IgorZeitz/PidgeonGuard/README_Images/schema.pdf

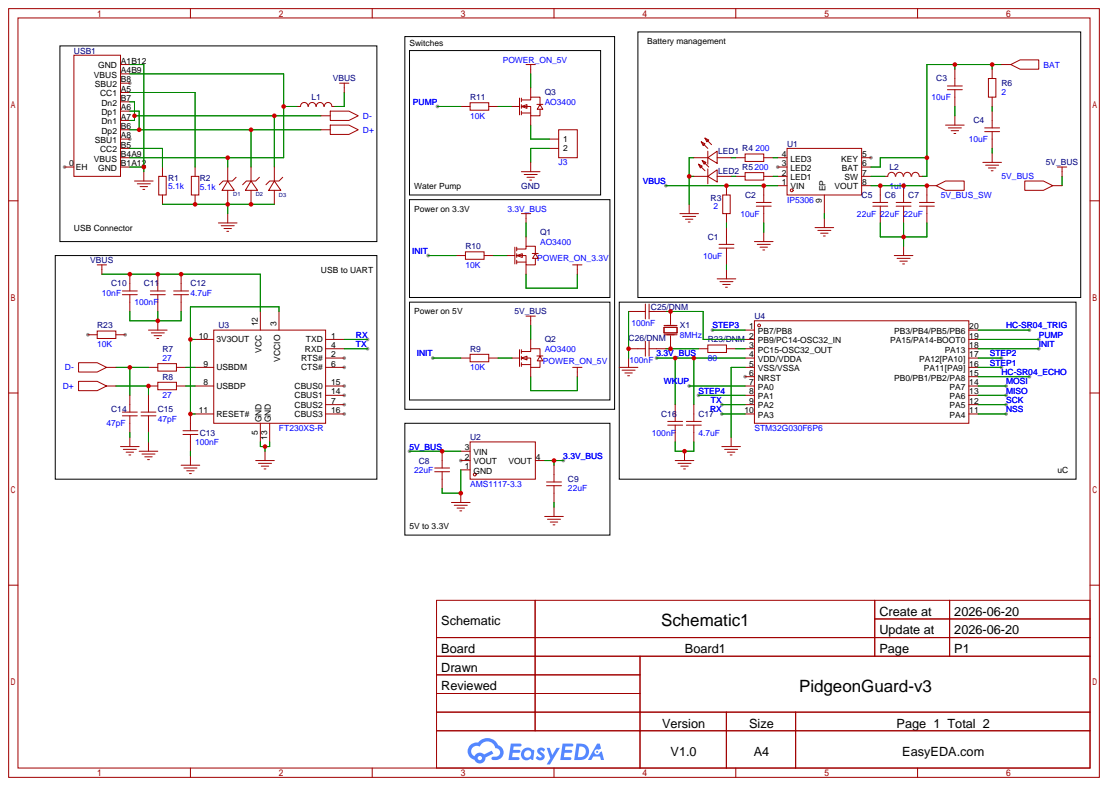
[picture p18: page 1]

Schematic | Schematic1 | Create at | 2026-06-20

Update at | 2026-06-20

Board | Board1 | Page | P1
Drawn | | PidgeonGuard-v3
Reviewed

Version | Size | Page 1 Total 2
V1.0 | A4 | EasyEDA.com

### MIC

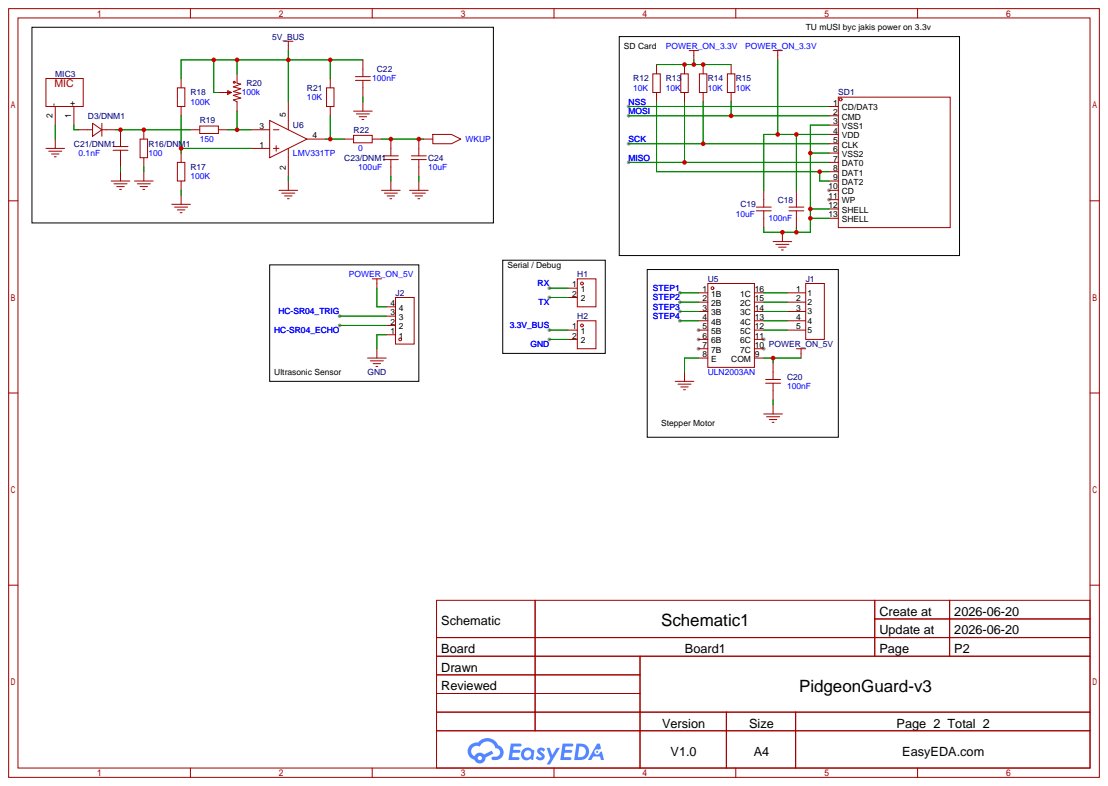
[picture p19: page 2]

TU mUSI byc jakis power on 3.3v

Schematic | Schematic1 | Create at | 2026-06-20

Update at | 2026-06-20

Board | Board1 | Page | P2
Drawn | | PidgeonGuard-v3
Reviewed

Version | Size | Page 2 Total 2
V1.0 | A4 | EasyEDA.com
