IgorZeitz/PidgeonGuard/README_Images/PCB_PCB1_2026-06-20_bot.pdf

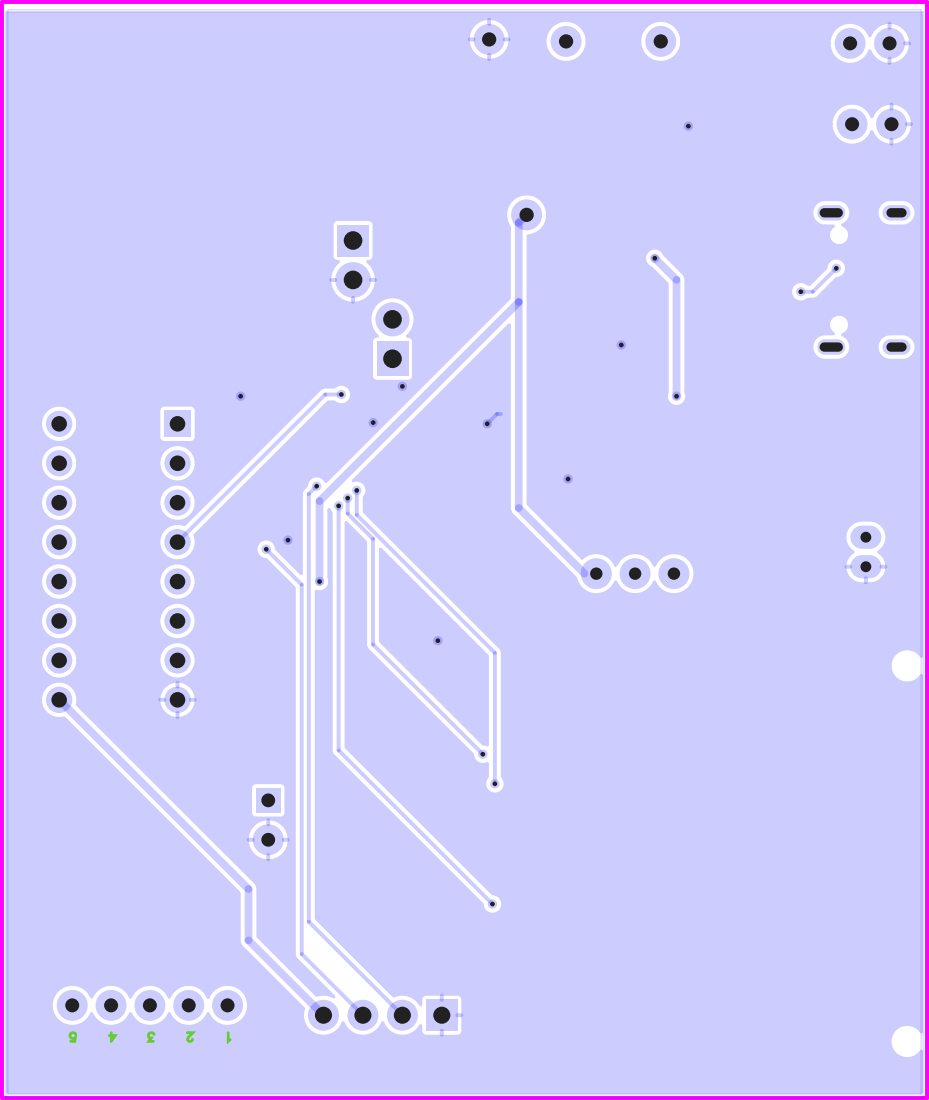
[picture p20: page 1]
