IgorZeitz/PidgeonGuard/README_Images/PCB_PCB1_2026-06-20_top.pdf

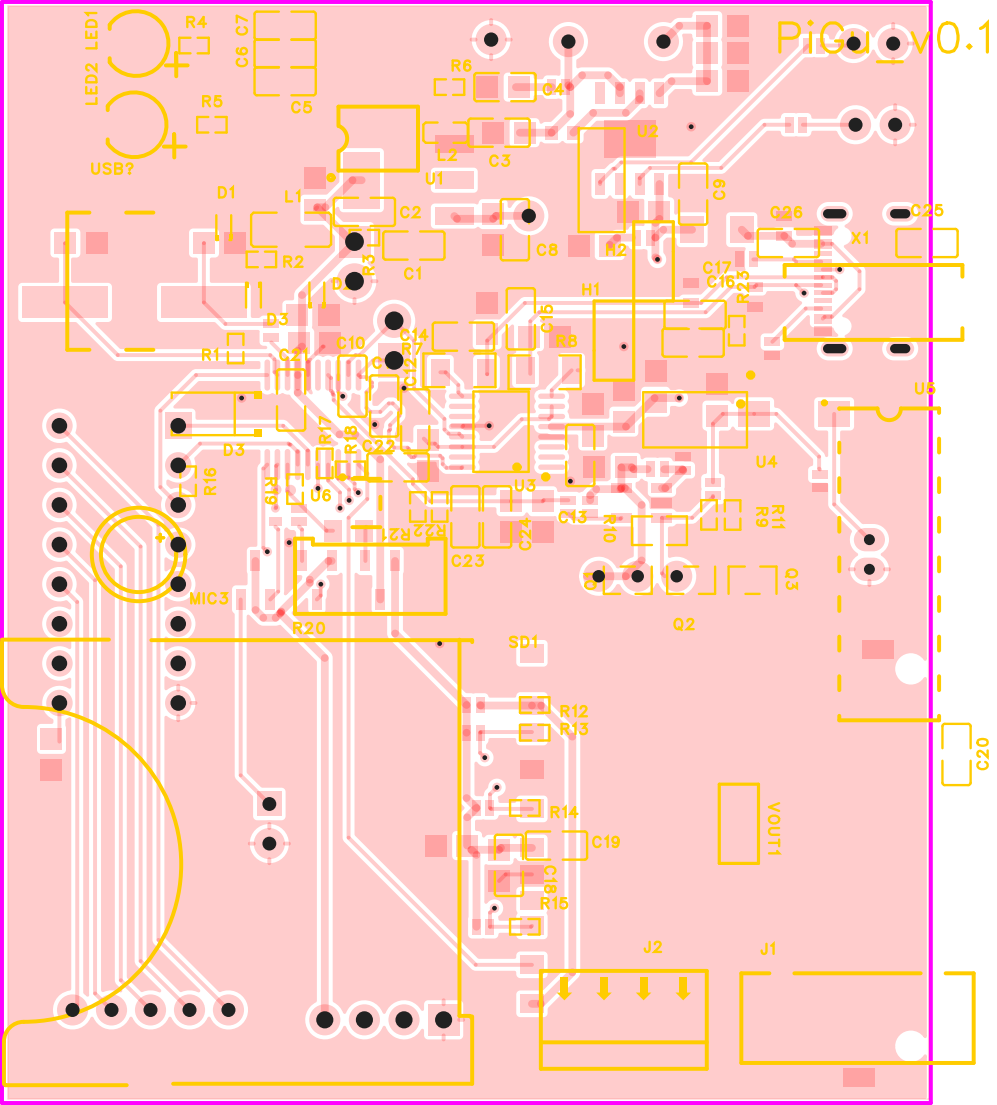
[picture p21: page 1]
