IgorZeitz/PidgeonGuard/Core/Src/main.c

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
/* Includes ------------------------------------------------------------------*/
#include "main.h"
#include "app_fatfs.h"

/* USER CODE BEGIN Includes */
#include <stdio.h>
#include <string.h>
/* USER CODE END Includes */

/* USER CODE BEGIN PTD */
#define TIM2_MAX_VALUE 0xFFFFFFFF

// HC-SR04 control pins
#define START_MEASURING_DISTANCE PC6
#define DISTANCE PB10

// Step motor defines
#define SMOTOR_INI1_PIN GPIO_PIN_1
#define SMOTOR_INI3_PIN GPIO_PIN_2
#define SMOTOR_INI2_PIN GPIO_PIN_5
#define SMOTOR_INI4_PIN GPIO_PIN_6

// Water pump control pin
#define PUMP_PORT GPIOB
#define PUMP_PIN GPIO_PIN_9

/* USER CODE END PTD */

RTC_HandleTypeDef hrtc;

SPI_HandleTypeDef hspi1;

TIM_HandleTypeDef htim2;

UART_HandleTypeDef huart1;

RTC_TimeTypeDef sTime;
RTC_DateTypeDef sDate;


/* USER CODE BEGIN PV */

char TxBuffer[250];
/* USER CODE END PV */

void SystemClock_Config(void);
static void MX_GPIO_Init(void);
static void MX_TIM2_Init(void);
static void MX_USART1_UART_Init(void);
static void MX_SPI1_Init(void);
static void MX_RTC_Init(void);
/* USER CODE BEGIN PFP */
void calculateDistance();
void controlSMotor(int32_t stepNumber, uint8_t direction);

void calibrateDistance();

void lookForTarget();

static void SD_Card_Test(void);
/* USER CODE END PFP */

/* USER CODE BEGIN 0 */

volatile uint32_t l_hcrs04Ticks1, l_hcrs04Ticks2;
volatile uint8_t l_hcrs04TimeCaptured = 0;
volatile uint32_t distance_L;

uint32_t mappedSourrounding[60];

/* USER CODE END 0 */

/**
  * @brief  The application entry point.
  * @retval int
  */


FATFS FatFs;
FIL Fil;
FRESULT FR_Status;
FATFS *FS_Ptr;
UINT RWC, WWC; // Read/Write Word Counter
DWORD FreeClusters;
uint32_t TotalSize, FreeSpace;
char RW_Buffer[200];

static void UART_Print(char* str)
{
    HAL_UART_Transmit(&huart1, (uint8_t *) str, strlen(str), 100);
}

int main(void)
{

  /* MCU Configuration--------------------------------------------------------*/

  /* Reset of all peripherals, Initializes the Flash interface and the Systick. */
  HAL_Init();

  /* Configure the system clock */
  SystemClock_Config();

  /* Initialize all configured peripherals */
  MX_GPIO_Init();
  MX_TIM2_Init();
  MX_USART1_UART_Init();
  MX_SPI1_Init();
  if (MX_FATFS_Init() != APP_OK) {
    Error_Handler();
  }
  MX_RTC_Init();
  /* USER CODE BEGIN 2 */

  // Enable interrupts for input capture timers for both HC-SR04
  HAL_TIM_IC_Start_IT(&htim2, TIM_CHANNEL_3);
  //HCSR04_Init(&htim3, GPIOC, GPIO_PIN_6);

  HAL_NVIC_EnableIRQ(TIM2_IRQn);

  HAL_PWR_EnableWakeUpPin(PWR_WAKEUP_PIN1_LOW);

  /* USER CODE END 2 */

  /* Infinite loop */
  /* USER CODE BEGIN WHILE */

  uint8_t message[64];
  //SD_Card_Test();
  //HCSR04_Init(&htim3, GPIOC, GPIO_PIN_6);
if(HAL_RTCEx_BKUPRead(&hrtc, RTC_BKP_DR1) != 0xBEEF){
  sTime.Hours = 21;
  sTime.Minutes = 37;
  sTime.Seconds = 0;

  HAL_RTC_SetTime(&hrtc, &sTime, RTC_FORMAT_BIN);

  sDate.WeekDay = RTC_WEEKDAY_MONDAY;
  sDate.Month = RTC_MONTH_APRIL;
  sDate.Date = 8;
  sDate.Year = 26;

  HAL_RTC_SetDate(&hrtc, &sDate, RTC_FORMAT_BIN);

  HAL_RTCEx_BKUPWrite(&hrtc, RTC_BKP_DR1, 0xBEEF);
}

  //HCSR04_startMeasurement();

  HAL_RTC_GetTime(&hrtc, &sTime, RTC_FORMAT_BIN);
  HAL_RTC_GetDate(&hrtc, &sDate, RTC_FORMAT_BIN);

  sprintf(RW_Buffer, "%02d-%02d-20%02d %02d:%02d:%02d\r\n",
          sDate.Date,
          sDate.Month,
          sDate.Year,
          sTime.Hours,
          sTime.Minutes,
          sTime.Seconds);

  f_mount(&FatFs, "", 1);
  f_open(&Fil, "TextFileWrite.txt", FA_WRITE | FA_READ);
  f_lseek(&Fil, f_size(&Fil));
  f_puts(RW_Buffer, &Fil);
  f_close(&Fil);
  //f_write(&Fil, RW_Buffer, strlen(RW_Buffer), &WWC);
 f_mount(NULL, "", 0);

	calibrateDistance();
  while (1)
  {

	  //distance = HCSR04_receiveDistance();

//	  	  HAL_GPIO_WritePin(GPIOC, GPIO_PIN_6, GPIO_PIN_SET);
//	  	  HAL_Delay(10);
//	  	  HAL_GPIO_WritePin(GPIOC, GPIO_PIN_6, GPIO_PIN_RESET);

//	  	  calculateDistance();

	  	  //distance = l_hcrs04Ticks2 - l_hcrs04Ticks1;
//	  	  sprintf((char*)message, "L: %lu\n", distance_L);
//	  	  HAL_UART_Transmit(&huart1, message, strlen((char*)message), 1000);



//	  	controlSMotor(2048, 0);

//	  	HAL_Delay(1000);

//	  	controlSMotor(2048, 1);



	  	HAL_Delay(5000);

	  	sprintf((char*)message, "MAP: %lu\n", mappedSourrounding[10]);
	  	HAL_UART_Transmit(&huart1, message, strlen((char*)message), 1000);

	  	//calibrateDistance();
	  	lookForTarget();

	  	__HAL_PWR_CLEAR_FLAG(PWR_FLAG_WU);
	  	__HAL_PWR_CLEAR_FLAG(PWR_FLAG_SB);

	  	HAL_PWREx_EnterSHUTDOWNMode();

//	  	  HAL_GPIO_WritePin(GPIOC, GPIO_PIN_6, GPIO_PIN_SET);
//	  	  HAL_Delay(10);
//	  	  HAL_GPIO_WritePin(GPIOC, GPIO_PIN_6, GPIO_PIN_RESET);
//
//	  	  calculateDistance();
//
//	  	  //distance = l_hcrs04Ticks2 - l_hcrs04Ticks1;
//	  	  sprintf((char*)message, "L: %lu\n", distance_L);
//	  	  HAL_UART_Transmit(&huart1, message, strlen((char*)message), 1000);
//
//	  	controlSMotor(2000, 1);
//
//	  	  HAL_Delay(2000);
    /* USER CODE END WHILE */

    /* USER CODE BEGIN 3 */
  }
  /* USER CODE END 3 */
}


static void SD_Card_Test(void)
{
  FATFS FatFs;
  FIL Fil;
  FRESULT FR_Status;
  FATFS *FS_Ptr;
  UINT RWC, WWC; // Read/Write Word Counter
  DWORD FreeClusters;
  uint32_t TotalSize, FreeSpace;
  char RW_Buffer[200];
  do
  {
    //------------------[ Mount The SD Card ]--------------------
    FR_Status = f_mount(&FatFs, "", 1);
    if (FR_Status != FR_OK)
    {
      sprintf(TxBuffer, "Error! While Mounting SD Card, Error Code: (%i)\r\n", FR_Status);
      UART_Print(TxBuffer);
      break;
    }
    sprintf(TxBuffer, "SD Card Mounted Successfully! \r\n\n");
    UART_Print(TxBuffer);
    //------------------[ Get & Print The SD Card Size & Free Space ]--------------------
    f_getfree("", &FreeClusters, &FS_Ptr);
    TotalSize = (uint32_t)((FS_Ptr->n_fatent - 2) * FS_Ptr->csize * 0.5);
    FreeSpace = (uint32_t)(FreeClusters * FS_Ptr->csize * 0.5);
    sprintf(TxBuffer, "Total SD Card Size: %lu Bytes\r\n", TotalSize);
    UART_Print(TxBuffer);
    sprintf(TxBuffer, "Free SD Card Space: %lu Bytes\r\n\n", FreeSpace);
    UART_Print(TxBuffer);
    //------------------[ Open A Text File For Write & Write Data ]--------------------
    //Open the file
    FR_Status = f_open(&Fil, "TextFileWrite.txt", FA_WRITE | FA_READ | FA_CREATE_ALWAYS);
    if(FR_Status != FR_OK)
    {
      sprintf(TxBuffer, "Error! While Creating/Opening A New Text File, Error Code: (%i)\r\n", FR_Status);
      UART_Print(TxBuffer);
      break;
    }
    sprintf(TxBuffer, "Text File Created & Opened! Writing Data To The Text File..\r\n\n");
    UART_Print(TxBuffer);
    // (1) Write Data To The Text File [ Using f_puts() Function ]
    f_puts("Hello! From STM32 To SD Card Over SPI, Using f_puts()\n", &Fil);
    // (2) Write Data To The Text File [ Using f_write() Function ]
    strcpy(RW_Buffer, "Hello! From STM32 To SD Card Over SPI, Using f_write()\r\n");
    f_write(&Fil, RW_Buffer, strlen(RW_Buffer), &WWC);
    // Close The File
    f_close(&Fil);
    //------------------[ Open A Text File For Read & Read Its Data ]--------------------
    // Open The File
    FR_Status = f_open(&Fil, "TextFileWrite.txt", FA_READ);
    if(FR_Status != FR_OK)
    {
      sprintf(TxBuffer, "Error! While Opening (TextFileWrite.txt) File For Read.. \r\n");
      UART_Print(TxBuffer);
      break;
    }
    // (1) Read The Text File's Data [ Using f_gets() Function ]
    f_gets(RW_Buffer, sizeof(RW_Buffer), &Fil);
    sprintf(TxBuffer, "Data Read From (TextFileWrite.txt) Using f_gets():%s", RW_Buffer);
    UART_Print(TxBuffer);
    // (2) Read The Text File's Data [ Using f_read() Function ]
    f_read(&Fil, RW_Buffer, f_size(&Fil), &RWC);
    sprintf(TxBuffer, "Data Read From (TextFileWrite.txt) Using f_read():%s", RW_Buffer);
    UART_Print(TxBuffer);
    // Close The File
    f_close(&Fil);
    sprintf(TxBuffer, "File Closed! \r\n\n");
    UART_Print(TxBuffer);
    //------------------[ Open An Existing Text File, Update Its Content, Read It Back ]--------------------
    // (1) Open The Existing File For Write (Update)
    FR_Status = f_open(&Fil, "TextFileWrite.txt", FA_OPEN_EXISTING | FA_WRITE);
    FR_Status = f_lseek(&Fil, f_size(&Fil)); // Move The File Pointer To The EOF (End-Of-File)
    if(FR_Status != FR_OK)
    {
      sprintf(TxBuffer, "Error! While Opening (TextFileWrite.txt) File For Update.. \r\n");
      UART_Print(TxBuffer);
      break;
    }
    // (2) Write New Line of Text Data To The File
    FR_Status = f_puts("This New Line Was Added During Update!\r\n", &Fil);
    f_close(&Fil);
    memset(RW_Buffer,'\0',sizeof(RW_Buffer)); // Clear The Buffer
    // (3) Read The Contents of The Text File After The Update
    FR_Status = f_open(&Fil, "TextFileWrite.txt", FA_READ); // Open The File For Read
    f_read(&Fil, RW_Buffer, f_size(&Fil), &RWC);
    sprintf(TxBuffer, "Data Read From (TextFileWrite.txt) After Update:%s", RW_Buffer);
    UART_Print(TxBuffer);
    f_close(&Fil);
    //------------------[ Delete The Text File ]--------------------
    // Delete The File
    /*
    FR_Status = f_unlink(TextFileWrite.txt);
    if (FR_Status != FR_OK){
        sprintf(TxBuffer, "Error! While Deleting The (TextFileWrite.txt) File.. \r\n");
        UART_Print(TxBuffer);
    }
    */
  } while(0);
  //------------------[ Test Complete! Unmount The SD Card ]--------------------
  FR_Status = f_mount(NULL, "", 0);
  if (FR_Status != FR_OK)
  {
      sprintf(TxBuffer, "Error! While Un-mounting SD Card, Error Code: (%i)\r\n", FR_Status);
      UART_Print(TxBuffer);
  } else{
      sprintf(TxBuffer, "SD Card Un-mounted Successfully! \r\n");
      UART_Print(TxBuffer);
  }
}


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
/* USER CODE BEGIN 4 */

//Timer input capture from HCSR04 sensors
void HAL_TIM_IC_CaptureCallback(TIM_HandleTypeDef *htim){

	// Left HCSR04 sensor response
	if (htim->Channel == HAL_TIM_ACTIVE_CHANNEL_3){	//CH3 = TIM2

	        if (l_hcrs04TimeCaptured == 0){	// First echo pin slope?
	        	l_hcrs04Ticks1 = HAL_TIM_ReadCapturedValue(htim, TIM_CHANNEL_3);	// capture sensor echo pin Rising Edge

	        	l_hcrs04TimeCaptured = 1;	// next time capture second echo pin slope
	            __HAL_TIM_SET_CAPTUREPOLARITY(htim, TIM_CHANNEL_3, TIM_INPUTCHANNELPOLARITY_FALLING);	// Set capturing Falling Edge
	        } else{

	        	l_hcrs04Ticks2 = HAL_TIM_ReadCapturedValue(htim, TIM_CHANNEL_3); // capture sensor echo pin Falling Edge

	        	l_hcrs04TimeCaptured = 0;	// next time capture first echo pin slope
	            __HAL_TIM_SET_CAPTUREPOLARITY(htim, TIM_CHANNEL_3, TIM_INPUTCHANNELPOLARITY_RISING);	// capture sensor echo pin Rising Edge
	        }
		}
}

void startDistanceMeasurement(){
	  HAL_GPIO_WritePin(GPIOC, GPIO_PIN_6, GPIO_PIN_SET);
	  HAL_Delay(10);
	  HAL_GPIO_WritePin(GPIOC, GPIO_PIN_6, GPIO_PIN_RESET);
}

void calculateDistance(){
	if(l_hcrs04Ticks2 > l_hcrs04Ticks1){
		distance_L = l_hcrs04Ticks2 - l_hcrs04Ticks1;
	} else distance_L = TIM2_MAX_VALUE - (l_hcrs04Ticks1 - l_hcrs04Ticks2);

	uint32_t message[16];
  	sprintf((char*)message, "DIST: %lu\n", distance_L);
  	HAL_UART_Transmit(&huart1, message, strlen((char*)message), 1000);
}


void controlSMotor(int32_t stepNumber, uint8_t direction){
	int32_t stepsPerformed = 0;
	if(direction == 0){
		while(stepNumber > stepsPerformed){	//	Turn Right
		switch (stepsPerformed % 4) {
		      case 0:  // 1010
		        HAL_GPIO_WritePin(GPIOB, SMOTOR_INI1_PIN, GPIO_PIN_SET);
		        HAL_GPIO_WritePin(GPIOB, SMOTOR_INI2_PIN, GPIO_PIN_RESET);
		        HAL_GPIO_WritePin(GPIOB, SMOTOR_INI3_PIN, GPIO_PIN_SET);
		        HAL_GPIO_WritePin(GPIOB, SMOTOR_INI4_PIN, GPIO_PIN_RESET);
		      break;
		      case 1:  // 0110
		        HAL_GPIO_WritePin(GPIOB, SMOTOR_INI1_PIN, GPIO_PIN_RESET);
		        HAL_GPIO_WritePin(GPIOB, SMOTOR_INI2_PIN, GPIO_PIN_SET);
		        HAL_GPIO_WritePin(GPIOB, SMOTOR_INI3_PIN, GPIO_PIN_SET);
		        HAL_GPIO_WritePin(GPIOB, SMOTOR_INI4_PIN, GPIO_PIN_RESET);
		      break;
		      case 2:  //0101
		        HAL_GPIO_WritePin(GPIOB, SMOTOR_INI1_PIN, GPIO_PIN_RESET);
		        HAL_GPIO_WritePin(GPIOB, SMOTOR_INI2_PIN, GPIO_PIN_SET);
		        HAL_GPIO_WritePin(GPIOB, SMOTOR_INI3_PIN, GPIO_PIN_RESET);
		        HAL_GPIO_WritePin(GPIOB, SMOTOR_INI4_PIN, GPIO_PIN_SET);
		      break;
		      case 3:  //1001
		        HAL_GPIO_WritePin(GPIOB, SMOTOR_INI1_PIN, GPIO_PIN_SET);
		        HAL_GPIO_WritePin(GPIOB, SMOTOR_INI2_PIN, GPIO_PIN_RESET);
		        HAL_GPIO_WritePin(GPIOB, SMOTOR_INI3_PIN, GPIO_PIN_RESET);
		        HAL_GPIO_WritePin(GPIOB, SMOTOR_INI4_PIN, GPIO_PIN_SET);
		      break;
		    }
		stepsPerformed++;
		HAL_Delay(5);
		}
	} else{
		while(stepNumber > stepsPerformed){	//	Turn Left
			switch ( stepNumber % 4) {
		      case 0:  // 1010
		        HAL_GPIO_WritePin(GPIOB, SMOTOR_INI1_PIN, GPIO_PIN_SET);
		        HAL_GPIO_WritePin(GPIOB, SMOTOR_INI2_PIN, GPIO_PIN_RESET);
		        HAL_GPIO_WritePin(GPIOB, SMOTOR_INI3_PIN, GPIO_PIN_SET);
		        HAL_GPIO_WritePin(GPIOB, SMOTOR_INI4_PIN, GPIO_PIN_RESET);
		      break;
		      case 1:  // 0110
		        HAL_GPIO_WritePin(GPIOB, SMOTOR_INI1_PIN, GPIO_PIN_RESET);
		        HAL_GPIO_WritePin(GPIOB, SMOTOR_INI2_PIN, GPIO_PIN_SET);
		        HAL_GPIO_WritePin(GPIOB, SMOTOR_INI3_PIN, GPIO_PIN_SET);
		        HAL_GPIO_WritePin(GPIOB, SMOTOR_INI4_PIN, GPIO_PIN_RESET);
		      break;
		      case 2:  //0101
		        HAL_GPIO_WritePin(GPIOB, SMOTOR_INI1_PIN, GPIO_PIN_RESET);
		        HAL_GPIO_WritePin(GPIOB, SMOTOR_INI2_PIN, GPIO_PIN_SET);
		        HAL_GPIO_WritePin(GPIOB, SMOTOR_INI3_PIN, GPIO_PIN_RESET);
		        HAL_GPIO_WritePin(GPIOB, SMOTOR_INI4_PIN, GPIO_PIN_SET);
		      break;
		      case 3:  //1001
		        HAL_GPIO_WritePin(GPIOB, SMOTOR_INI1_PIN, GPIO_PIN_SET);
		        HAL_GPIO_WritePin(GPIOB, SMOTOR_INI2_PIN, GPIO_PIN_RESET);
		        HAL_GPIO_WritePin(GPIOB, SMOTOR_INI3_PIN, GPIO_PIN_RESET);
		        HAL_GPIO_WritePin(GPIOB, SMOTOR_INI4_PIN, GPIO_PIN_SET);
		      break;
			    }
			stepNumber--;
		HAL_Delay(5);
		}
	}
}


void calibrateDistance(){

	uint8_t oneStep = 12;
	uint8_t numberOfMeasurements = 60;

	startDistanceMeasurement();
	HAL_Delay(5);		// delay and second measurement to make sure that first measured value isn't trash
	startDistanceMeasurement();
	calculateDistance();
	mappedSourrounding[0] = distance_L;

	for(uint8_t i = 0; i < numberOfMeasurements; ){

		controlSMotor(oneStep, 0);

		startDistanceMeasurement();
		calculateDistance();
		i++;

		mappedSourrounding[i] = distance_L;
	}

	controlSMotor(720, 1); // Return to the max left side of sensor sight

	//sprintf((char*)message, "L: %lu\n", distance_L);
	uint32_t message[16];
	sprintf((char*)message, "Calibration Completed.\n");
	HAL_UART_Transmit(&huart1, message, strlen((char*)message), 1000);

}


void lookForTarget(){
	uint8_t oneStep = 12;
	uint8_t numberOfMeasurements = 60;
	uint8_t measurementsTaken = 0;

	for(uint8_t i = 0; i<4; i++ ){ // Repeat full scanning 4 times

		for(; measurementsTaken < numberOfMeasurements; ){
			uint32_t message[16];
				sprintf((char*)message, "STRZELAĆ!!!");


				startDistanceMeasurement();
				calculateDistance();

				uint32_t supposedValue = mappedSourrounding[measurementsTaken];

				controlSMotor(oneStep, 0);
				measurementsTaken++;

				while(distance_L + 1000 < supposedValue){
					HAL_GPIO_TogglePin(PUMP_PORT, PUMP_PIN);

					HAL_UART_Transmit(&huart1, message, strlen((char*)message), 1000);
					HAL_Delay(50);

					HAL_GPIO_TogglePin(PUMP_PORT, PUMP_PIN);

					uint32_t lastDistance = distance_L;

					startDistanceMeasurement();
					calculateDistance();

					if(lastDistance - 70 > distance_L){

						lastDistance = distance_L;

						controlSMotor(oneStep, 0);
						HAL_GPIO_TogglePin(PUMP_PORT, PUMP_PIN);

						HAL_UART_Transmit(&huart1, message, strlen((char*)message), 1000);
						HAL_Delay(50);
						HAL_GPIO_TogglePin(PUMP_PORT, PUMP_PIN);

						startDistanceMeasurement();
						calculateDistance();

						measurementsTaken++;

					} else if(lastDistance < distance_L - 70){

						lastDistance = distance_L;

						controlSMotor(oneStep, 1);
						HAL_GPIO_TogglePin(PUMP_PORT, PUMP_PIN);

						HAL_UART_Transmit(&huart1, message, strlen((char*)message), 1000);
						HAL_Delay(50);
						HAL_GPIO_TogglePin(PUMP_PORT, PUMP_PIN);

						startDistanceMeasurement();
						calculateDistance();

						measurementsTaken--;
					} else{
						// ERROR???
					}
				}



			}

		if(measurementsTaken == 60){ // If sensor reached max right side turn direction

			for(; measurementsTaken > 0; ){
				uint32_t message[16];
					sprintf((char*)message, "STRZELAĆ!!!");


				startDistanceMeasurement();
				calculateDistance();

				uint32_t supposedValue = mappedSourrounding[measurementsTaken];

				controlSMotor(oneStep, 1);
				measurementsTaken--;

				while(distance_L + 1000 < supposedValue){


					HAL_GPIO_TogglePin(PUMP_PORT, PUMP_PIN);

					HAL_UART_Transmit(&huart1, message, strlen((char*)message), 1000);
					HAL_Delay(50);
					HAL_GPIO_TogglePin(PUMP_PORT, PUMP_PIN);

					uint32_t lastDistance = distance_L;

					startDistanceMeasurement();
					calculateDistance();


					if(lastDistance - 70 > distance_L){

						lastDistance = distance_L;

						controlSMotor(oneStep, 1);
						HAL_GPIO_TogglePin(PUMP_PORT, PUMP_PIN);

						HAL_UART_Transmit(&huart1, message, strlen((char*)message), 1000);
						HAL_Delay(50);
						HAL_GPIO_TogglePin(PUMP_PORT, PUMP_PIN);

						startDistanceMeasurement();
						calculateDistance();

						measurementsTaken--;

					} else if(lastDistance < distance_L - 70){

						lastDistance = distance_L;

						controlSMotor(oneStep, 0);
						HAL_GPIO_TogglePin(PUMP_PORT, PUMP_PIN);

						HAL_UART_Transmit(&huart1, message, strlen((char*)message), 1000);
						HAL_Delay(50);
						HAL_GPIO_TogglePin(PUMP_PORT, PUMP_PIN);


						startDistanceMeasurement();
						calculateDistance();

						measurementsTaken++;
					} else{
						// ERROR???
					}
				}



			}
		}

		if(measurementsTaken > 60){
			measurementsTaken = 0;	// If some error appears and the function is stuck, zero the counter
		}

	}
}
/* USER CODE END 4 */
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
