IgorZeitz/PidgeonGuard/PidgeonGuard.ioc

Mcu.UserName=STM32G491RETx
PA0.Signal=SYS_WKUP1
PA13.GPIO_Label=T_SWDIO
PA13.Signal=SYS_JTMS-SWDIO
PA14.GPIO_Label=T_SWCLK
PA14.Signal=SYS_JTCK-SWCLK
PA2.GPIO_Label=LPUART1_TX [STLINKV3E_VCP_RX]
PA2.Signal=LPUART1_TX
PA3.GPIO_Label=LPUART1_RX [STLINKV3E_VCP_TX]
PA3.Signal=LPUART1_RX
PA4.Signal=GPIO_Output
PA5.Signal=SPI1_SCK
PA6.Signal=SPI1_MISO
PA7.Signal=SPI1_MOSI
PB1.Signal=GPIO_Output
PB10.Signal=S_TIM2_CH3
PB2.Signal=GPIO_Output
PB3.GPIO_Label=T_SWO
PB3.Signal=SYS_JTDO-SWO
PB5.Signal=GPIO_Output
PB6.Signal=GPIO_Output
PB9.Signal=GPIO_Output
PC13.GPIO_Label=B1 [blue push button]
PC13.Signal=GPXTI13
PC14-OSC32_IN.GPIO_Label=RCC_OSC32_IN
PC14-OSC32_IN.Signal=RCC_OSC32_IN
PC15-OSC32_OUT.GPIO_Label=RCC_OSC32_OUT
PC15-OSC32_OUT.Signal=RCC_OSC32_OUT
PC4.Signal=USART1_TX
PC5.Signal=USART1_RX
PC6.Signal=GPIO_Output
PF0-OSC_IN.GPIO_Label=RCC_OSC_IN
PF0-OSC_IN.Signal=RCC_OSC_IN
PF1-OSC_OUT.GPIO_Label=RCC_OSC_OUT
PF1-OSC_OUT.Signal=RCC_OSC_OUT
