IgorZeitz/PidgeonGuard/Core/Inc/HCSR04_Driver.h

///*
// * HCSR04_Driver.h
// *
// *  Created on: Feb 21, 2026
// *      Author: 48794
// */
//
//#ifndef INC_HCSR04_DRIVER_H_
//#define INC_HCSR04_DRIVER_H_
//
//#define CLK_FREQ 1000000
//
//#include "main.h"
//#include <stdint.h>
//
//void HCSR04_Init(TIM_HandleTypeDef *htim,
//                 GPIO_TypeDef *trig_port,
//                 uint16_t trig_pin);
//
//void HCSR04_startMeasurement(void);
//
//uint32_t HCSR04_receiveDistance(void);
//
//void HCSR04_IC_Callback(TIM_HandleTypeDef *htim);
//
//#endif
