IgorZeitz/PidgeonGuard/(commit log)

2026-03-07 Initial commit. Ultrasonic + stepper motor distance following implemented
2026-03-07 water pump control
2026-03-21 Added mcu entering the shutdown mode after calibration and 4 full scans - to exit shutdown mode an external sound detector is used to pull down a NRST reset pin after detecing a lound sound
2026-03-28 changed mcu waking up from NRST to WKUP_PIN1 to protect restarting device before shutdown
2026-04-08 FatFs + SPI sd card test for mcu wake up logs
